1kvihaan-lab/flight-computer/pcb (2).png

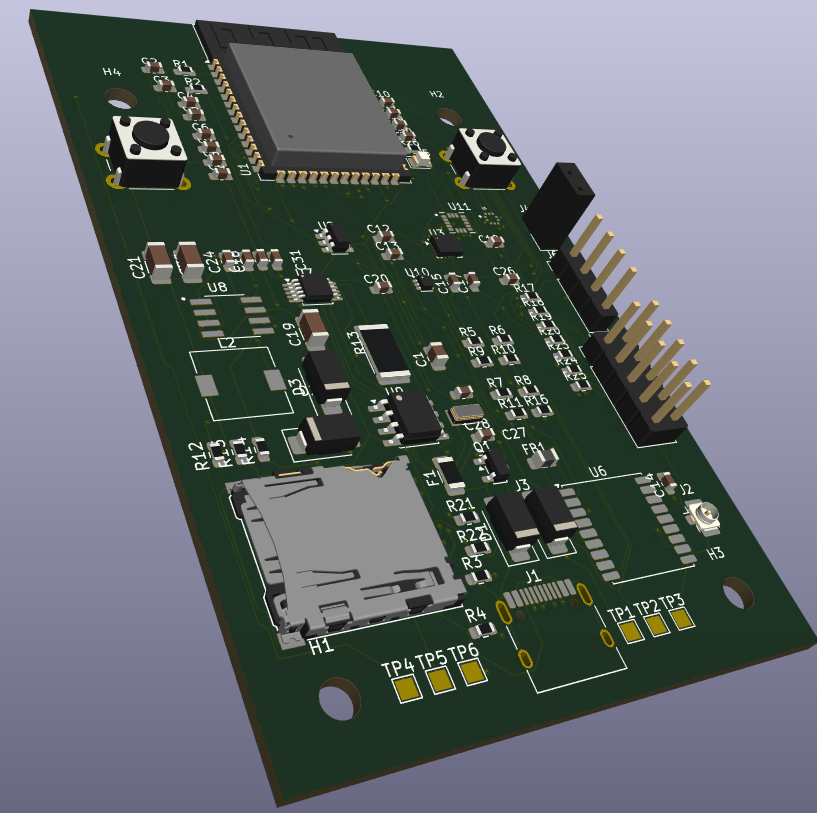
pcb (2).png
