1kvihaan-lab/flight-computer/PCB.png

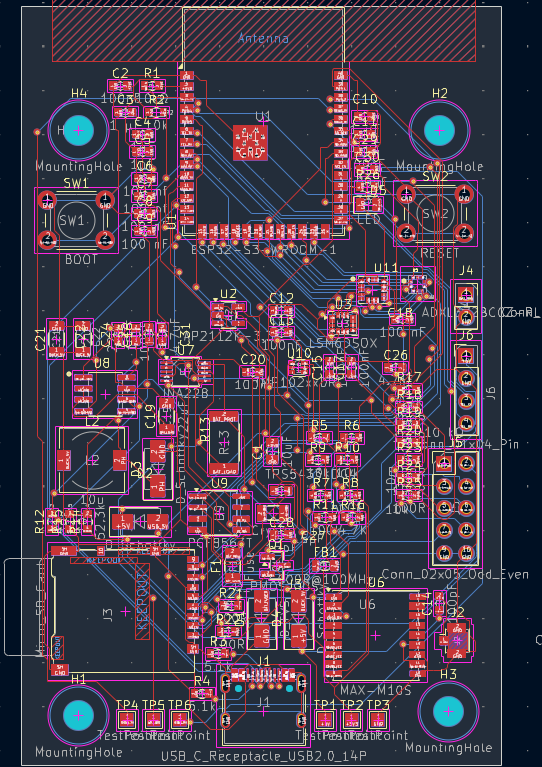
PCB.png
