1kvihaan-lab/flight-computer/Schematic.png

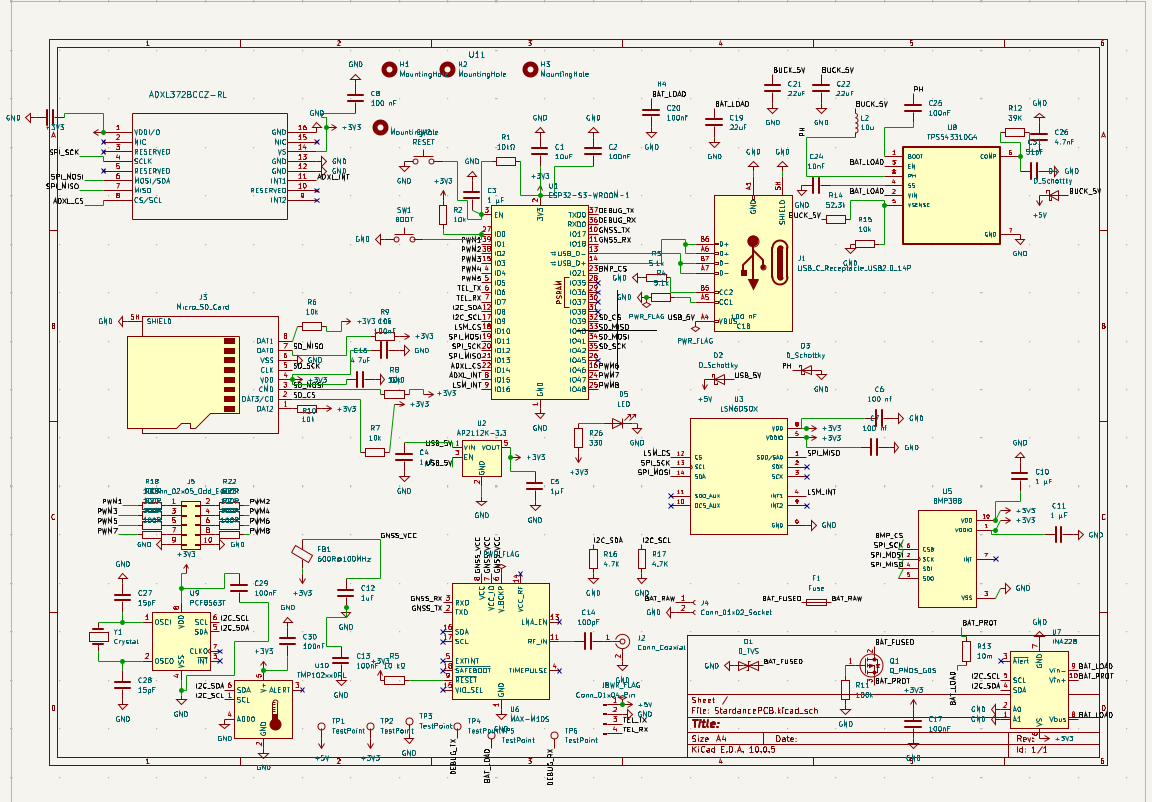
Schematic.png
