1kvihaan-lab/flight-computer/Stardance BOM.xlsx

Item Name | Qty | Price (total) (USD) | Item link | Notes
ESP32-S3-WROOM-1-N16R8 module (onboard PCB antenna) | 1 | $5.20 | https://octopart.com/search?q=ESP32-S3-WROOM-1-N16R8 (https://example.com/example_item) | Main MCU with Wi-Fi/BLE. Antenna end needs a copper-free keep-out: no ground pour, no battery, no metal in front of it. Confirm the exact flash/PSRAM suffix used in the schematic.
u-blox MAX-M10S GNSS receiver | 1 | $16.50 | https://octopart.com/search?q=MAX-M10S | Second most expensive part. Runs from the separate /GNSS_VCC rail so ESP32 transmit bursts do not disturb it. Check stock and lead time before fixing a build date.
ADXL372BCCZ-RL7 high-g accelerometer | 1 | $17.00 | https://octopart.com/search?q=ADXL372BCCZ-RL7 | 16-pad LGA, 3.0 x 3.25 mm (CC-16-4). NOT pin-compatible with ADXL363 (pin 5/7/8 differ) - do not substitute. Solder-mask apertures are 1:1 with the pads on purpose; tell the fab not to apply mask expansion.
LSM6DSOXTR 6-axis IMU | 1 | $5.50 | https://octopart.com/search?q=LSM6DSOXTR | I2C. Orientation/attitude reference. Shares the bus with BMP388, PCF8563T and INA228 - check address straps for collisions.
BMP388 barometric pressure sensor | 1 | $3.20 | https://octopart.com/search?q=BMP388 | I2C. Needs a vent plus light shielding in the enclosure; treat altitude as relative, not absolute.
PCF8563T RTC | 1 | $1.40 | https://octopart.com/search?q=PCF8563T | I2C, battery-backed so time survives power removal. Re-sync from GNSS time on every fix.
Crystal 32.768 kHz, FC-135 3.2x1.5 mm (Y1) | 1 | $0.70 | https://octopart.com/search?q=FC-135%2032.768kHz | RTC crystal. Keep traces short with a local ground guard; do not route SPI clock or GNSS supply near it.
INA228 20-bit current/power monitor | 1 | $6.50 | https://octopart.com/search?q=INA228 | I2C, measures through the 10 mOhm shunt. Set the shunt value and full-scale range in firmware; a wrong constant gives readings off by a fixed factor.
AP2112K-3.3 LDO regulator | 1 | $0.35 | https://octopart.com/search?q=AP2112K-3.3 | 600 mA LDO. Dissipates (Vin - 3.3) x Iload - roughly 0.18 W at 200 mA from a 4.2 V cell. Check temperature inside a sealed enclosure.
USB-C receptacle, HRO TYPE-C-31-M-12 (14-pin, USB 2.0) | 1 | $1.10 | https://octopart.com/search?q=TYPE-C-31-M-12 | USB 2.0 only, no USB-PD. The 5.1k CC pull-downs are mandatory or a USB-C host will not supply 5 V.
Header 2x5, 2.54 mm (debug / expansion) | 1 | $0.45 | https://octopart.com/search?q=2x5%20header%202.54mm | Boot/reset and expansion. Can be left unpopulated if you program over USB only.
Header 1x4, 2.54 mm (auxiliary) | 1 | $0.30 | https://octopart.com/search?q=1x4%20header%202.54mm | Secondary connector, typically serial console or an external sensor.
Current-sense shunt 10 mOhm, 1%, low-TCR | 1 | $0.70 | https://octopart.com/search?q=10%20milliohm%20shunt%20resistor%202512%201% | Must be low-TCR / low-inductance. A generic thick-film part will skew current readings with temperature and load transients.
Schottky diode, reverse / back-feed protection | 1 | $0.35 | https://octopart.com/search?q=SS14%20schottky%20SOD-123 | Confirm the exact part number from the schematic before ordering.
Ferrite bead 600 Ohm @ 100 MHz | 1 | $0.12 | https://octopart.com/search?q=600%20ohm%20100MHz%20ferrite%20bead%200603 | Filters high-frequency noise out of the GNSS supply branch.
Resistors, 0402/0603 assorted (10k, 100k, 100R, 52.3k, 5.1k, 4.7k) | 30 | $0.90 | https://octopart.com/search?q=0402%20resistor%20assortment | ESTIMATED COUNT. Exact quantities and values must come from the KiCad schematic export (BOM + position file). 5.1k parts are the USB-C CC pull-downs.
Capacitors, 0402/0603 assorted (100nF, 1uF, 10uF, 22uF, 10nF, 4.7nF, 15pF) | 25 | $1.20 | https://octopart.com/search?q=0402%20capacitor%20assortment | Decoupling plus crystal load caps. ESTIMATED COUNT - export the real list from KiCad.
Test points | 5 | $0.25 | https://octopart.com/search?q=PCB%20test%20point%20SMD | For probing the rails and buses at bring-up.
Total Price (USD):
BUILD COST SUMMARY - 5 boards (5 is the usual PCBA minimum order)
Parts, one board
Parts, 5 boards
PCB fabrication, 5 pcs, 54.5 x 86.2 mm, 2-layer, 1.6 mm |  | $5.00 |  | Under the 100 x 100 mm price tier. ENIG finish recommended for the LGA pads.
PCBA assembly: setup, stencil, labour (5 boards) |  | $110.00 |  | Approx 250 SMT joints, ~75 unique parts, IPC-A-610 Class 2. One-time setup dominates at this quantity.
Shipping (DHL, approx 1 kg) |  | $50.00 |  | Estimate; varies with destination and speed.
TOTAL, 5 boards
Unit cost per board
Prices are ESTIMATES at 1-10 off distributor pricing (Nov 2026) and exist to size the budget, not to buy from. Replace them with the PCBWay generated quote PDF.
Quantities are for ONE board unless noted. The two passive lines are counts estimated from the design - export the real BOM from KiCad before ordering.
Bare PCB alone is only ~$5 for the lot; almost all of the cost is components plus the one-time assembly setup fee.
At 50 boards the setup fee amortises and the unit cost falls to roughly $65-70 per board.
Open blocker before ordering: the last DRC still reported unconnected pads and clearance violations. Fix those first - turnkey assembly will not catch a netlist error.
