1kvihaan-lab/flight-computer/BOM.csv

Id | Designator | Footprint | Quantity | Designation | Supplier and ref
1 | C1 | C_0805_2012Metric | 1 | 10uF
2 | C2, C13, C15, C17, C25, C29, C30 | C_0603_1608Metric | 7 | 100nF
3 | C3, C10, C11 | C_0603_1608Metric | 3 | 1 µF
4 | C4, C5 | C_0603_1608Metric | 2 | 1µF
5 | C6, C7 | C_0603_1608Metric | 2 | 100 nf
6 | C8, C9, C18 | C_0603_1608Metric | 3 | 100 nF
7 | C12 | C_0603_1608Metric | 1 | 1uF
8 | C14 | C_0603_1608Metric | 1 | 100pF
9 | C16 | C_0603_1608Metric | 1 | 4.7uF
10 | C19, C21, C22 | C_1206_3216Metric | 3 | 22uF
11 | C20 | C_0603_1608Metric | 1 | 100nf
12 | C24 | C_0603_1608Metric | 1 | 10nF
13 | C26 | C_0603_1608Metric | 1 | 4.7nF
14 | C27, C28 | C_0603_1608Metric | 2 | 15pF
15 | C31 | C_0603_1608Metric | 1 | 51pF
16 | D1 | D_SMA | 1 | D_TVS
17 | D2, D3, D4 | D_SMA | 3 | D_Schottky
18 | D5 | LED_0805_2012Metric | 1 | LED
19 | F1 | Fuse_1206_3216Metric | 1 | Fuse
20 | FB1 | L_0805_2012Metric | 1 | 600R@100MHz
21 | J1 | USB_C_Receptacle_HRO_TYPE-C-31-M-12 | 1 | USB_C_Receptacle_USB2.0_14P
22 | J2 | U.FL_Hirose_U.FL-R-SMT-1_Vertical | 1 | Conn_Coaxial
23 | J3 | microSD_HC_Hirose_DM3AT-SF-PEJM5 | 1 | Micro_SD_Card
24 | J4 | PinSocket_1x02_P2.54mm_Vertical | 1 | Conn_01x02_Socket
25 | J5 | PinHeader_2x05_P2.54mm_Vertical | 1 | Conn_02x05_Odd_Even
26 | J6 | PinHeader_1x04_P2.54mm_Vertical | 1 | Conn_01x04_Pin
27 | L2 | L_7.3x7.3_H3.5 | 1 | 10u
28 | Q1 | SOT-23 | 1 | Q_PMOS_GDS
29 | R1 | R_0603_1608Metric | 1 | 10kΩ
30 | R2, R6, R7, R8, R9, R10, R15 | R_0603_1608Metric | 7 | 10k
31 | R3, R4 | R_0603_1608Metric | 2 | 5.1k
32 | R5 | R_0603_1608Metric | 1 | 10 kΩ
33 | R11 | R_0603_1608Metric | 1 | 100k
34 | R12 | R_0603_1608Metric | 1 | 39K
35 | R13 | R_2512_6332Metric | 1 | 10m
36 | R14 | R_0603_1608Metric | 1 | 52.3k
37 | R16, R17 | R_0603_1608Metric | 2 | 4.7K
38 | R18, R19, R20, R21, R22, R23, R24, R25 | R_0603_1608Metric | 8 | 100R
39 | R26 | R_0603_1608Metric | 1 | 330
40 | SW1 | SW_PUSH_6mm | 1 | BOOT
41 | SW2 | SW_PUSH_6mm | 1 | RESET
42 | TP1, TP2, TP3, TP4, TP5, TP6 | TestPoint_Pad_1.5x1.5mm | 6 | TestPoint
43 | U1 | ESP32-S3-WROOM-1 | 1 | ESP32-S3-WROOM-1
44 | U2 | SOT-23-5 | 1 | AP2112K-3.3
45 | U3 | LGA-14_3x2.5mm_P0.5mm_LayoutBorder3x4y | 1 | LSM6DSOX
46 | U5 | XDCR_BMP388 | 1 | BMP388
47 | U6 | ublox_MAX | 1 | MAX-M10S
48 | U7 | TSSOP-10_3x3mm_P0.5mm | 1 | INA228
49 | U8 | SOIC127P599X175-8N | 1 | TPS54331DG4
50 | U9 | SOIC-8_3.9x4.9mm_P1.27mm | 1 | PCF8563T
51 | U10 | SOT-563 | 1 | TMP102xxDRL
52 | U11 | PQFN50P322X300X114-16N | 1 | ADXL372BCCZ-RL
53 | Y1 | Crystal_SMD_3215-2Pin_3.2x1.5mm | 1 | Crystal
