1kvihaan-lab/flight-computer/StardancePCB.step

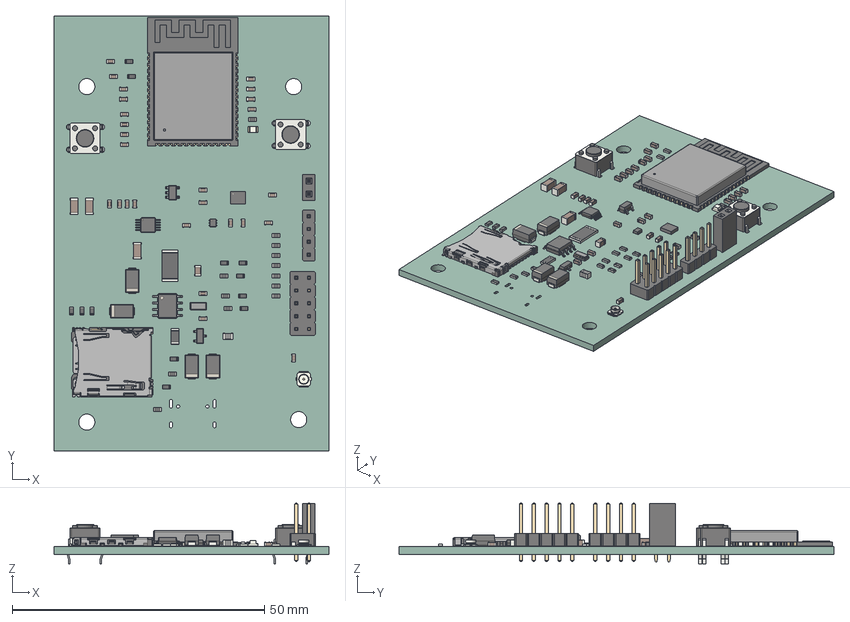
[picture p4: CAD file, 2026-11-08]
StardancePCB.step
54.5 x 86.2 x 12.0 mm
R_0603_1608Metric x 25
C_0603_1608Metric x 26
C_1206_3216Metric x 3
TSSOP-10_3x3mm_P0.5mm
SOIC-8_3.9x4.9mm_P1.27mm
R_2512_6332Metric
PinHeader_2x05_P254mm_Vertical
LGA_14_3x25mm_P05mm_LayoutBorder3x4y
PinHeader_1x04_P254mm_Vertical
L_0805_2012Metric
SOT-23-5
C_0805_2012Metric
D_SMA x 4
SOT_563
SOT-23
Crystal_SMD_3215-2Pin_3.2x1.5mm
PinSocket_1x02_P2.54mm_Vertical
LED_0805_2012Metric
Fuse_1206_3216Metric
SW_PUSH_6mm x 2
microSD_HC_Hirose_DM3AT-SF-PEJM5
U.FL_Hirose_U.FL-R-SMT-1_Vertical
ESP32-S3-WROOM-1
Sta415B_PCB
