1kvihaan-lab/flight-computer/StardancePCB.kicad_pcb

## KiCad design StardancePCB.kicad_pcb (2026-10-31)

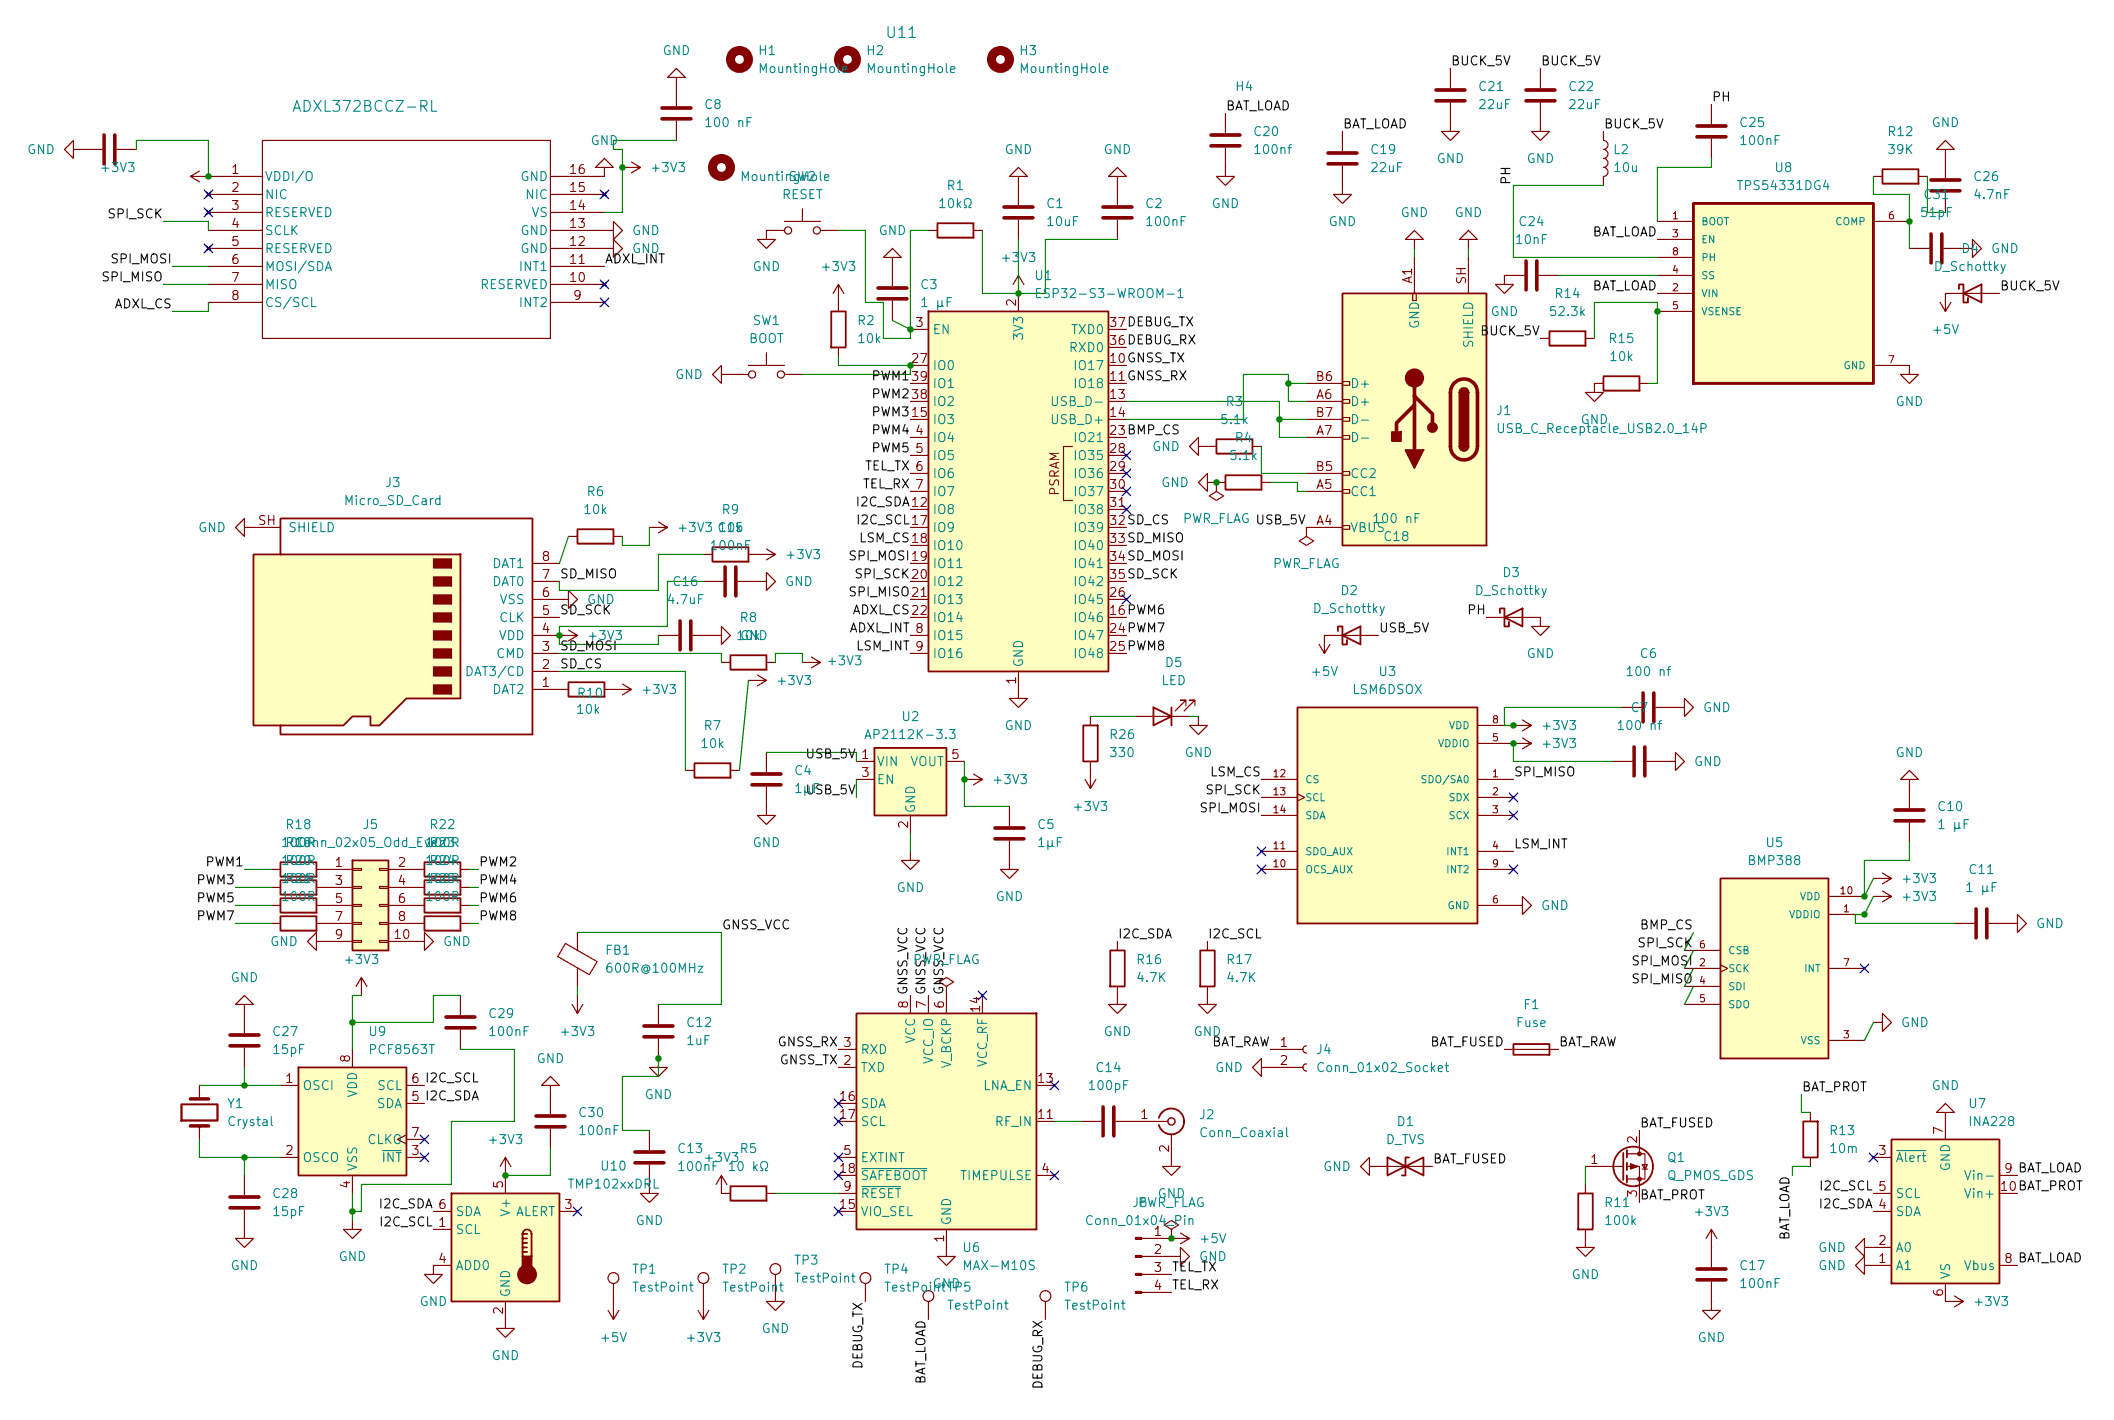
[picture p5: schematic StardancePCB.kicad_sch]

Parts:
C1: 10uF; C_0805_2012Metric
C2, C13, C15, C17, C25, C29, C30: 100nF; C_0603_1608Metric
C3, C10, C11: 1 µF; C_0603_1608Metric
C4, C5: 1µF; C_0603_1608Metric
C6, C7: 100 nf; C_0603_1608Metric
C8, C18: 100 nF; C_0603_1608Metric
C12: 1uF; C_0603_1608Metric
C14: 100pF; C_0603_1608Metric
C16: 4.7uF; C_0603_1608Metric
C19, C21, C22: 22uF; C_1206_3216Metric
C20: 100nf; C_0603_1608Metric
C24: 10nF; C_0603_1608Metric
C26: 4.7nF; C_0603_1608Metric
C27, C28: 15pF; C_0603_1608Metric
C31: 51pF; C_0603_1608Metric
D1: D_TVS; D_SMA
D2, D3, D4: D_Schottky; D_SMA
D5: LED; LED_0805_2012Metric
F1: Fuse; Fuse_1206_3216Metric
FB1: 600R@100MHz; L_0805_2012Metric
H1, H2, H3, H4: MountingHole; MountingHole_3.2mm_M3
J1: USB_C_Receptacle_USB2.0_14P; USB_C_Receptacle_HRO_TYPE-C-31-M-12
J2: Conn_Coaxial; U.FL_Hirose_U.FL-R-SMT-1_Vertical
J3: Micro_SD_Card; microSD_HC_Hirose_DM3AT-SF-PEJM5
J4: Conn_01x02_Socket; PinSocket_1x02_P2.54mm_Vertical
J5: Conn_02x05_Odd_Even; PinHeader_2x05_P2.54mm_Vertical
J6: Conn_01x04_Pin; PinHeader_1x04_P2.54mm_Vertical
L2: 10u; L_7.3x7.3_H3.5
Q1: Q_PMOS_GDS; SOT-23
R1: 10kΩ; R_0603_1608Metric
R2, R6, R7, R8, R9, R10, R15: 10k; R_0603_1608Metric
R3, R4: 5.1k; R_0603_1608Metric
R5: 10 kΩ; R_0603_1608Metric
R11: 100k; R_0603_1608Metric
R12: 39K; R_0603_1608Metric
R13: 10m; R_2512_6332Metric
R14: 52.3k; R_0603_1608Metric
R16, R17: 4.7K; R_0603_1608Metric
R18, R19, R20, R21, R22, R23, R24, R25: 100R; R_0603_1608Metric
R26: 330; R_0603_1608Metric
SW1: BOOT; SW_PUSH_6mm
SW2: RESET; SW_PUSH_6mm
TP1, TP2, TP3, TP4, TP5, TP6: TestPoint; TestPoint_Pad_1.5x1.5mm
U1: ESP32-S3-WROOM-1
U2: AP2112K-3.3; SOT-23-5
U3: LSM6DSOX; LGA-14_3x2.5mm_P0.5mm_LayoutBorder3x4y; PARTREV 3.0
U5: BMP388; XDCR_BMP388; PARTREV 1.7
U6: MAX-M10S; ublox_MAX
U7: INA228; TSSOP-10_3x3mm_P0.5mm
U8: TPS54331DG4; SOIC127P599X175-8N
U9: PCF8563T; SOIC-8_3.9x4.9mm_P1.27mm
U10: TMP102xxDRL; SOT-563
U11: ADXL372BCCZ-RL; PQFN50P322X300X114-16N
Y1: Crystal; Crystal_SMD_3215-2Pin_3.2x1.5mm

Connections:
+3V3: C1.2, C2.2, C5.1, C6.1, C7.1, C8.2, C10.2, C11.1, C15.1, C16.1, C17.1, C18.2, C29.1, C30.2, FB1.2, J3.4 (VDD), R1.2, R2.1, R5.1, R6.2, R7.2, R8.2, R9.2, R10.2, R26.1, TP2.1 (1_1), U1.2 (3V3), U2.5 (VOUT), U3.5 (VDDIO), U3.8 (VDD), U5.1 (VDDIO), U5.10 (VDD), U7.6 (VS), U9.8 (VDD), U10.5 (V+), U11.1 (VDDI/O), U11.14 (VS); also elsewhere on the board
+5V: D2.1 (K), D4.1 (K), J6.1, TP1.1 (1_1)
/ADXL_CS: U1.22 (IO14), U11.8 (CS/SCL)
/ADXL_INT: U1.8 (IO15), U11.11 (INT1)
/BAT_FUSED: D1.2 (A2), F1.1, Q1.2 (D)
/BAT_LOAD: C19.1, C20.1, R13.1, TP5.1 (1_1), U7.8 (Vbus), U7.9 (Vin-), U8.2 (VIN), U8.3 (EN)
/BAT_PROT: Q1.3 (S), R13.2, U7.10 (Vin+)
/BAT_RAW: F1.2, J4.1
/BMP_CS: U1.23 (IO21), U5.6 (CSB)
/BUCK_5V: C21.1, C22.1, D4.2 (A), L2.1, R14.1
/DEBUG_RX: TP6.1 (1_1), U1.36 (RXD0)
/DEBUG_TX: TP4.1 (1_1), U1.37 (TXD0)
/GNSS_RX: U1.11 (IO18), U6.3 (RXD)
/GNSS_TX: U1.10 (IO17), U6.2 (TXD)
/GNSS_VCC: C12.1, FB1.1, U6.6 (V_BCKP), U6.7 (VCC_IO), U6.8 (VCC)
/I2C_SCL: R17.1, U1.17 (IO9), U7.5 (SCL), U9.6 (SCL), U10.1 (SCL)
/I2C_SDA: R16.1, U1.12 (IO8), U7.4 (SDA), U9.5 (SDA), U10.6 (SDA)
/LSM_CS: U1.18 (IO10), U3.12 (CS)
/LSM_INT: U1.9 (IO16), U3.4 (INT1)
/PH: C25.1, D3.1 (K), L2.2, U8.8 (PH)
/PWM1: R18.1, U1.39 (IO1)
/PWM2: R22.2, U1.38 (IO2)
/PWM3: R19.1, U1.15 (IO3)
/PWM4: R23.2, U1.4 (IO4)
/PWM5: R20.1, U1.5 (IO5)
/PWM6: R24.2, U1.16 (IO46)
/PWM7: R21.1, U1.24 (IO47)
/PWM8: R25.2, U1.25 (IO48)
/SD_CS: J3.2 (DAT3/CD), R7.1, U1.32 (IO39)
/SD_MISO: J3.7 (DAT0), R9.1, U1.33 (IO40)
/SD_MOSI: J3.3 (CMD), R8.1, U1.34 (IO41)
/SD_SCK: J3.5 (CLK), U1.35 (IO42)
/SPI_MISO: U1.21 (IO13), U3.1 (SDO/SA0), U5.5 (SDO), U11.7 (MISO)
/SPI_MOSI: U1.19 (IO11), U3.14 (SDA), U5.4 (SDI), U11.6 (MOSI/SDA)
/SPI_SCK: U1.20 (IO12), U3.13 (SCL), U5.2 (SCK), U11.4 (SCLK)
/TEL_RX: J6.4, U1.7 (IO7)
/TEL_TX: J6.3, U1.6 (IO6)
/USB_5V: C4.1, D2.2 (A), J1.A4 (VBUS), J1.A9 (VBUS), J1.B4 (VBUS), J1.B9 (VBUS), U2.1 (VIN), U2.3 (EN)
GND: C1.1, C2.1, C3.1, C4.2, C5.2, C6.2, C7.2, C8.1, C10.1, C11.2, C12.2, C13.1, C13.2, C15.2, C16.2, C17.2, C18.1, C19.2, C20.2, C21.2, C22.2, C24.1, C26.1, C27.1, C28.2, C29.2, C30.1, C31.2, D1.1 (A1), D3.2 (A), D5.1 (K), J1.A1 (GND), J1.A12 (GND), J1.B1 (GND), J1.B12 (GND), J1.SH (SHIELD), J2.2 (Ext), J3.6 (VSS), J3.SH (SHIELD), J4.2, J5.9, J5.10, J6.2, R3.1, R4.1, R11.2, R15.1, R16.2, R17.2, SW1.1, SW2.1, TP3.1 (1_1), U1.1 (GND), U1.40 (GND), U1.41 (GND), U2.2 (GND), U3.6 (GND), U3.7 (GND), U5.3 (VSS), U5.8 (VSS), U5.9 (VSS), U6.1 (GND), U6.10 (GND), U6.12 (GND), U7.1 (A1), U7.2 (A0), U7.7 (GND), U8.7 (GND), U9.4 (VSS), U10.2 (GND), U10.4 (ADD0), U11.12 (GND), U11.13 (GND), U11.16 (GND); also elsewhere on the board
unnamed: C26.2, R12.2
unnamed: D5.2 (A), R26.2
unnamed: J1.A5 (CC1), R4.2
unnamed: J1.B5 (CC2), R3.2
unnamed: C14.2, J2.1 (In)
unnamed: J3.8 (DAT1), R6.1
unnamed: J3.1 (DAT2), R10.1
unnamed: J5.1, R18.2
unnamed: J5.2, R22.1
unnamed: J5.3, R19.2
unnamed: J5.4, R23.1
unnamed: J5.5, R20.2
unnamed: J5.6, R24.1
unnamed: J5.7, R21.2
unnamed: J5.8, R25.1
unnamed: Q1.1 (G), R11.1
unnamed: C3.2, R1.1, SW2.2, U1.3 (EN)
unnamed: R2.2, SW1.2, U1.27 (IO0)
unnamed: J1.A6 (D+), J1.B6 (D+), U1.14 (USB_D+)
unnamed: J1.A7 (D-), J1.B7 (D-), U1.13 (USB_D-)
unnamed: C14.1, U6.11 (RF_IN)
unnamed: R5.2, U6.9 (~RESET)
unnamed: C25.2, U8.1 (BOOT)
unnamed: C31.1, R12.1, U8.6 (COMP)
unnamed: C24.2, U8.4 (SS)
unnamed: R14.2, R15.2, U8.5 (VSENSE)
unnamed: C27.2, U9.1 (OSCI), Y1.2
unnamed: C28.1, U9.2 (OSCO), Y1.1

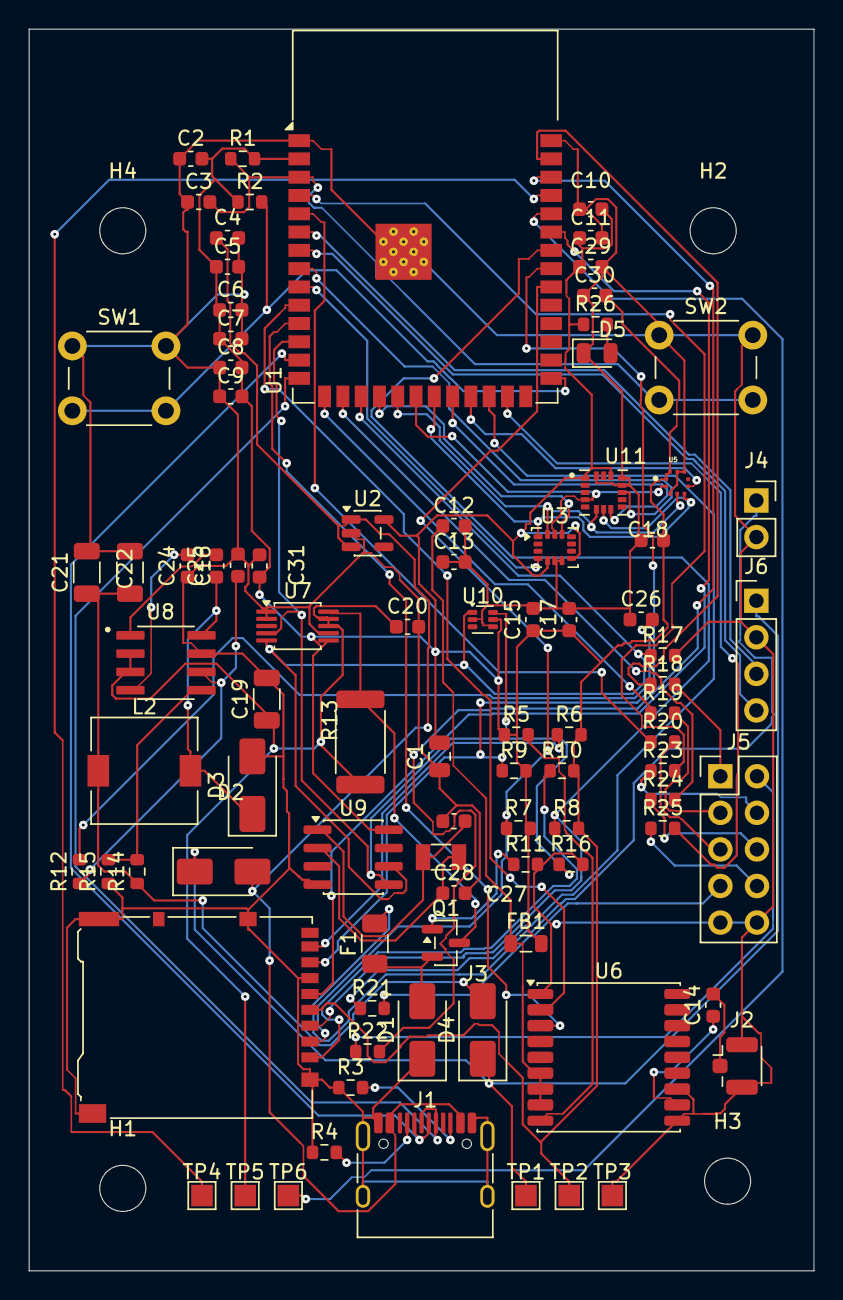
[picture p6: board StardancePCB.kicad_pcb from above]

Board: 2 copper layers, 54.5 x 86.2 mm, 94 parts (0 on the bottom side), 67 nets.

Other parts of the board:
C9: 100 nF; C_0603_1608Metric

Their connections:
+3V3: C9.2; also elsewhere on the board
GND: C9.1; also elsewhere on the board
